svdeepak99/RIUP/(commit log)

2021-02-21 Wired Calibration Arduino Oscillators
    [Clock_Check_RX.ino, Clock_Check_TX.ino]
2021-02-21 Wireless Calibration of Arduino Oscillators
    [Clock_Check_Radio_RX_2.ino, Clock_Check_Radio_TX_2.ino]
2021-02-21 2D Positioning with 2 Ultrasound transmitters
    This code successfully estimates the (x,y) coordinate of a bot/receiver station, when the coordinates of the 2 Ultrasound transmitters are provided. The time is synced by using RF signals similar to Step-3, and an RF signal is transmitted before Ultrasound is transmitted from each of the sensors from the transmitter station.
    The stationary transmitter station has the transmitter Arduino connected to the RF transmitter, and 2 Ultrasound transmitters which are placed perpendicular near the ceiling of the room facing the mobile receiver station downwards.
    The mobile receiver station has the receiver Arduino, connected to an Ultrasound receiver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
